Junquilh0/FM-radio/Radio 1/Radio 1.kicad_pcb

## KiCad design Radio 1/Radio 1.kicad_pcb (2026-10-18)

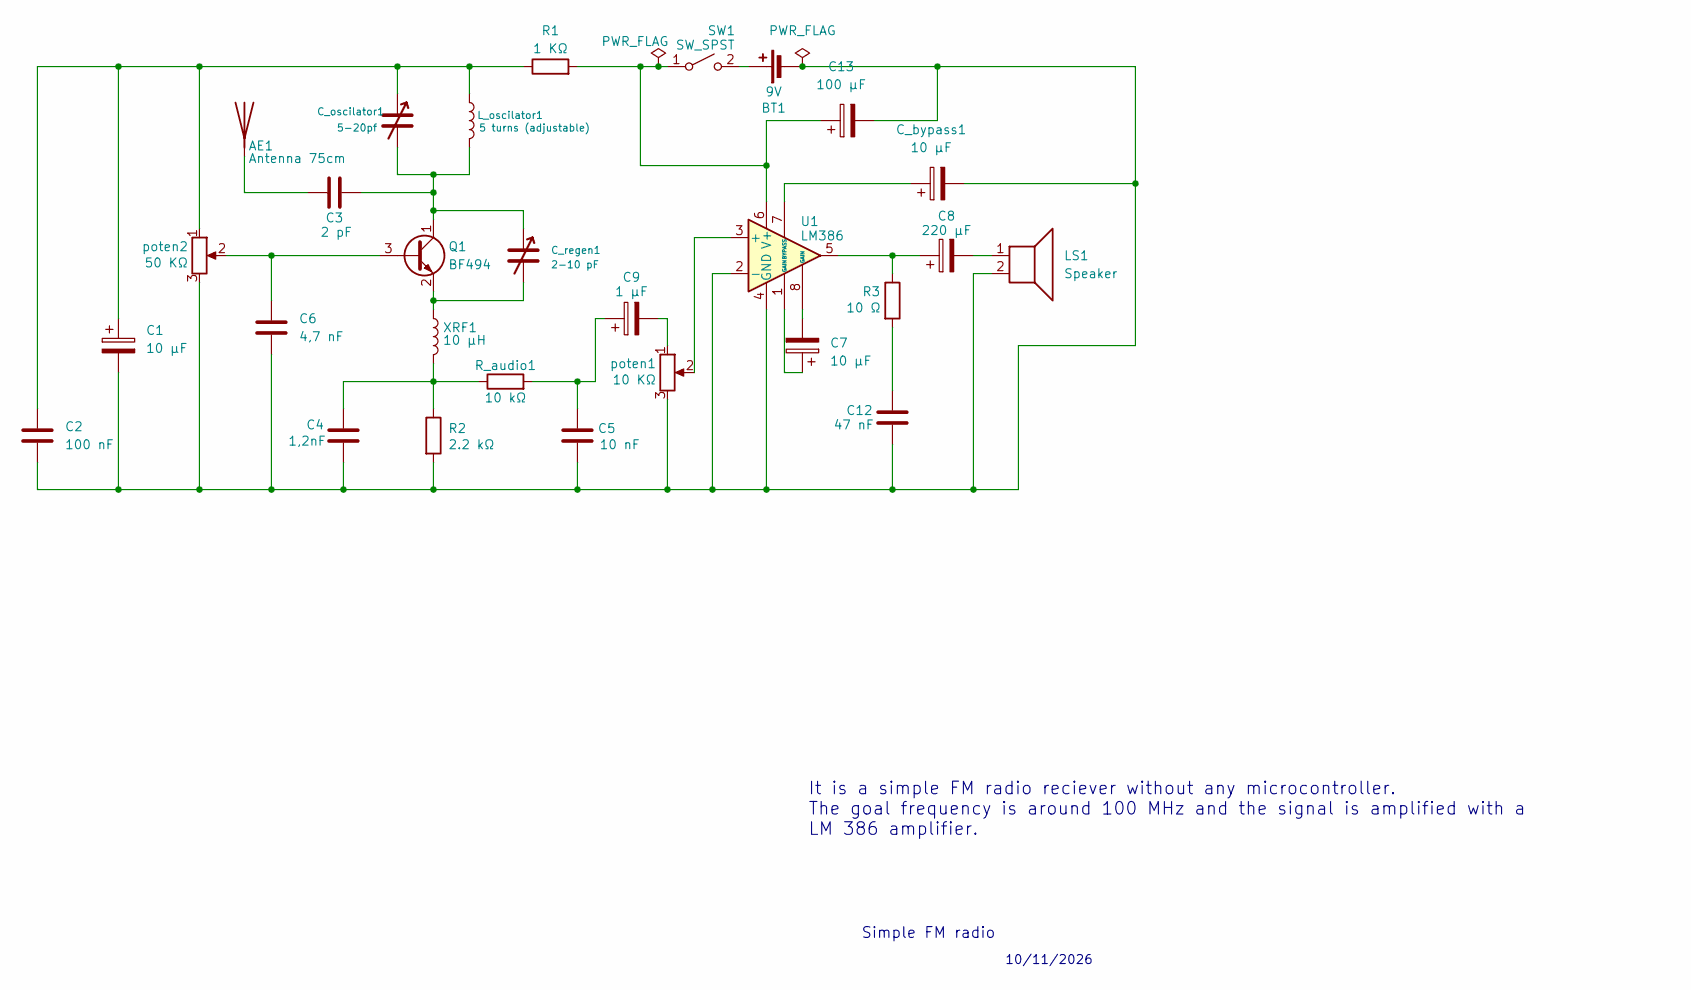
[picture p5: schematic Radio 1.kicad_sch]

Parts:
AE1: Antenna 75cm; Wire_1x01_P2.54mm
BT1: 9V; Wire_1x02_P2.54mm
C1, C7: 10 μF; CP_Radial_D5.0mm_P2.00mm
C2: 100 nF; C_Ceramic_Slot_P2.54-5.08mm
C3: 2 pF; C_Ceramic_Slot_P2.54-5.08mm
C4: 1,2nF; C_Ceramic_Slot_P2.54-5.08mm
C5: 10 nF; C_Ceramic_Slot_P2.54-5.08mm
C6: 4,7 nF; C_Ceramic_Slot_P2.54-5.08mm
C8: 220 μF; CP_Radial_D8.0mm_P3.50mm
C9: 1 μF; CP_Radial_D5.0mm_P2.00mm
C12: 47 nF; C_Ceramic_Slot_P2.54-5.08mm
C13: 100 μF; CP_Radial_D6.3mm_P2.50mm
C_bypass1: 10 μF; CP_Radial_D5.0mm_P2.00mm
C_oscilator1: 5-20pf; Trimmer_C_Slot_P2.5-5.08mm
C_regen1: 2-10 pF; Trimmer_C_Slot_P2.5-5.08mm
LS1: Speaker; Wire_1x02_P2.54mm
L_oscilator1: 5 turns (adjustable); L_Air_P7.62mm_Handwound
Q1: BF494; TO-92_Inline_CEB
R1: 1 KΩ; R_Axial_L6.3mm_D2.5mm_P10.16mm
R2: 2.2 kΩ; R_Axial_L6.3mm_D2.5mm_P10.16mm
R3: 10 Ω; R_Axial_L6.3mm_D2.5mm_P10.16mm
R_audio1: 10 kΩ; R_Axial_L6.3mm_D2.5mm_P10.16mm
SW1: SW_SPST; Wire_1x03_P2.54mm
U1: LM386; DIP-8_W7.62mm_LM386
XRF1: 10 μH; L_Radial_Slot_P5.0-7.5mm
poten1: 10 KΩ; Wire_1x03_P2.54mm
poten2: 50 KΩ; Wire_1x03_P2.54mm

Connections:
unnamed: AE1.1 (A_1), C3.1
unnamed: BT1.1 (+), SW1.2 (B)
unnamed: BT1.2 (-), C1.2, C2.2, C4.2, C5.2, C6.2, C12.2, C13.2, C_bypass1.2, LS1.2, R2.2, U1.2 (-), U1.4 (GND), poten1.3, poten2.3
unnamed: C1.1, C2.1, C_oscilator1.1, L_oscilator1.1, R1.1, poten2.1
unnamed: C4.1, R2.1, R_audio1.1, XRF1.2
unnamed: C5.1, C9.1, R_audio1.2
unnamed: C7.1, U1.1 (GAIN)
unnamed: C7.2, U1.8 (GAIN)
unnamed: C8.1, R3.1, U1.5
unnamed: C8.2, LS1.1
unnamed: C9.2, poten1.1
unnamed: C12.1, R3.2
unnamed: C6.1, Q1.3 (B), poten2.2
unnamed: C3.2, C_oscilator1.2, C_regen1.1, L_oscilator1.2, Q1.1 (C)
unnamed: C_regen1.2, Q1.2 (E), XRF1.1
unnamed: C13.1, R1.2, SW1.1 (A), U1.6 (V+)
unnamed: U1.3 (+), poten1.2
unnamed: C_bypass1.1, U1.7 (BYPASS)

Notes on the sheet:
10/11/2026
Simple FM radio
It is a simple FM radio reciever without any microcontroller. The goal frequency is around 100 MHz and the signal is amplified with a LM 386 amplifier.

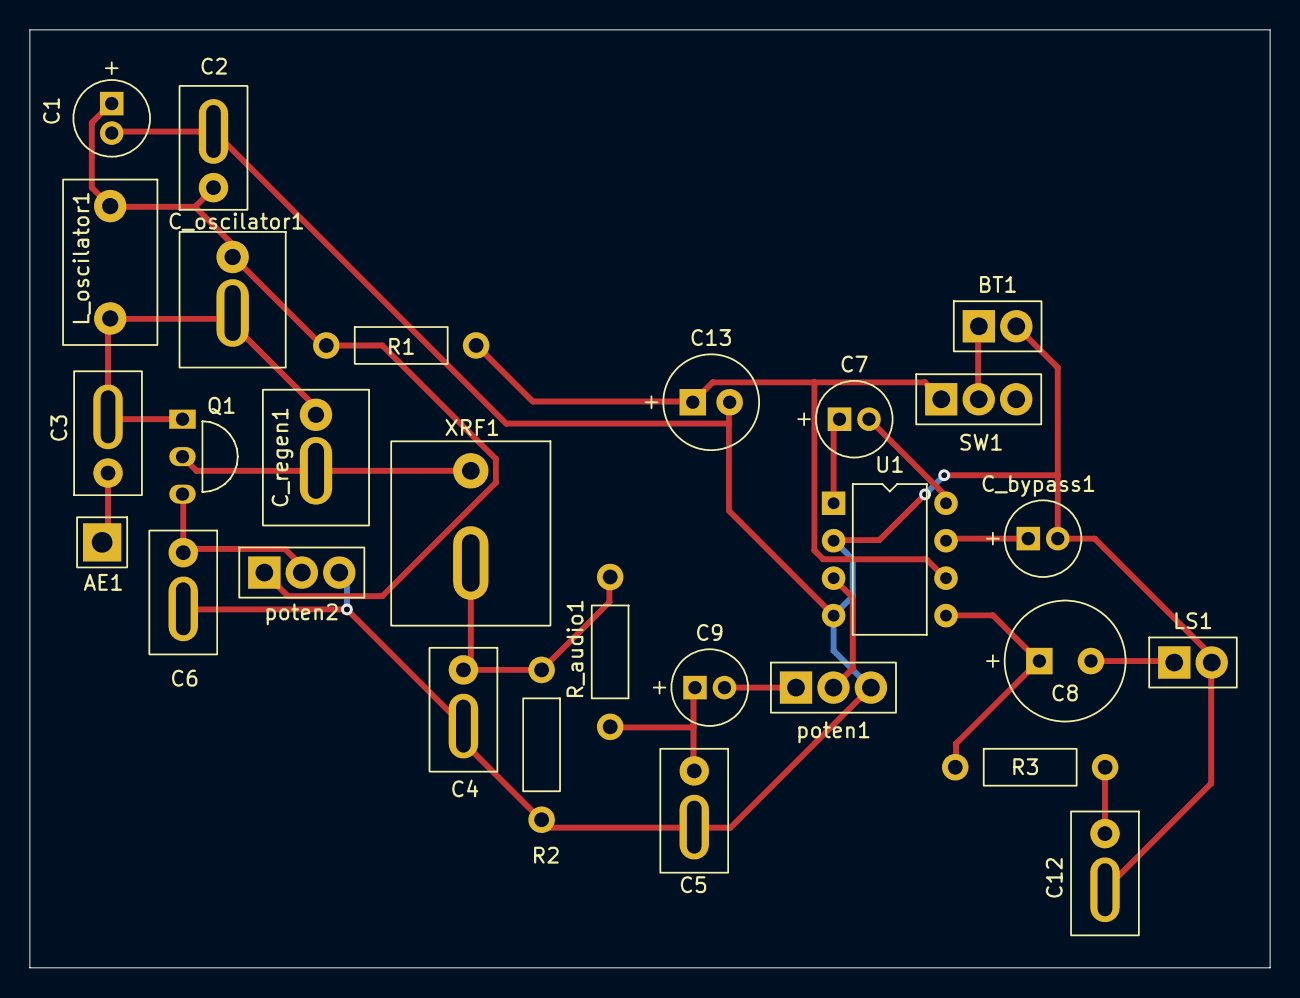
[picture p6: board Radio 1.kicad_pcb from above]

Board: 2 copper layers, 84.1 x 63.6 mm, 28 parts (0 on the bottom side), 18 nets.
