Junquilh0/FM-radio/JOURNAL.md

# FM simple radio – devlog

<!-- Generated by Half Life from project cmv1mty79000v01q308dl4htq. Edits here are overwritten on the next sync. -->
<!-- Generated: 2026-10-12T01:50:23.219Z -->

> [!NOTE]
> This devlog is mirrored from [Half Life](https://halflife.hackclub.com). Editing it here will not change the platform's copy, and the next sync overwrites this file.

| Week | Tier | Hours logged | Entries |
| --- | --- | --- | --- |
| Week 1 | Tier 1 | 5.87h | 2 |

## Contents

1. [2026-10-11 – In this session i spent a lot of time learning how a radio works and what type of radio i was trying to build. Luckly after sometime i started to getting it and started planing the radio. I already di](#2026-10-11-in-this-session-i-spent-a-lot-of-time-learning-ho)
2. [2026-10-11 – In this entry i simply finished the sketch by adding the amplification part. Then i started looking for footprints to add to each component but since they dont have specifications in the shoping site,](#2026-10-11-in-this-entry-i-simply-finished-the-sketch-by-add)

## Design

### 2026-10-11 – In this session i spent a lot of time learning how a radio works and what type of radio i was trying to build. Luckly after sometime i started to getting it and started planing the radio. I already di

**2.8h**

In this session i spent a lot of time learning how a radio works and what type of radio i was trying to build. Luckly after sometime i started to getting it and started planing the radio. I already did all of the oscilator (i think) and next ill do the amplification part.



[Timelapse](https://lookout.hackclub.com/api/media/625731c7-dab8-4e2f-af8b-081f3ddcd732/video.mp4)

### 2026-10-11 – In this entry i simply finished the sketch by adding the amplification part. Then i started looking for footprints to add to each component but since they dont have specifications in the shoping site,

**3.07h**

In this entry i simply finished the sketch by adding the amplification part. Then i started looking for footprints to add to each component but since they dont have specifications in the shoping site, i had to choose and modify some of the footprints from the existing libraries. Then (while in a lapse pause) i created my own librarie of footprints to be easier to organize myslef. in the next entry i will make the pcb and finish everything

[Timelapse](https://lookout.hackclub.com/api/media/f2e88609-899d-4a93-b1dc-be933f93ce65/video.mp4)
