Junquilh0/FM-radio/(commit log)

2026-10-18 Rename Radio 1.csv to bom*.csv
    [bom*.csv]
2026-10-18 Modify Slide switch entry in BOM
    Updated the entry for Slide switch (SW1) to indicate already having it.
    [bom*.csv]
